EmbryoPhenomics/RoboCam/software/snap_images/snap-17.png

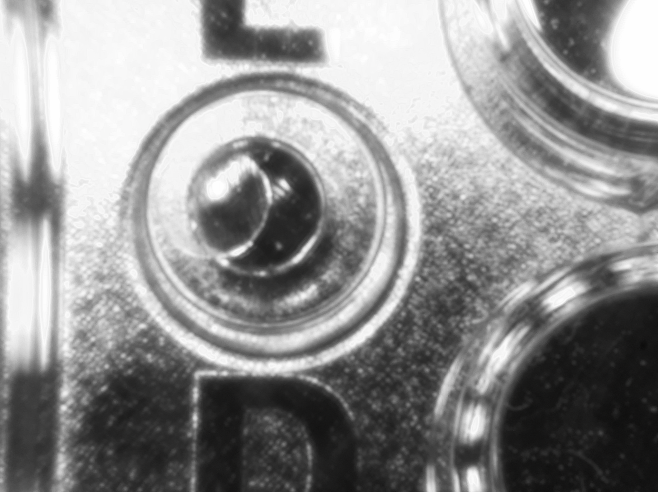
software/snap_images/snap-17.png
