EmbryoPhenomics/RoboCam/software/snap_images/snap-18.png

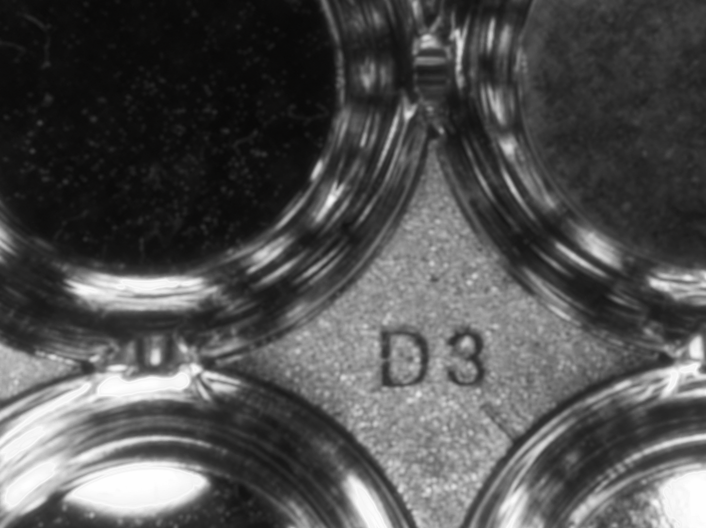
software/snap_images/snap-18.png
