EmbryoPhenomics/RoboCam/software/snap_images/snap-19.png

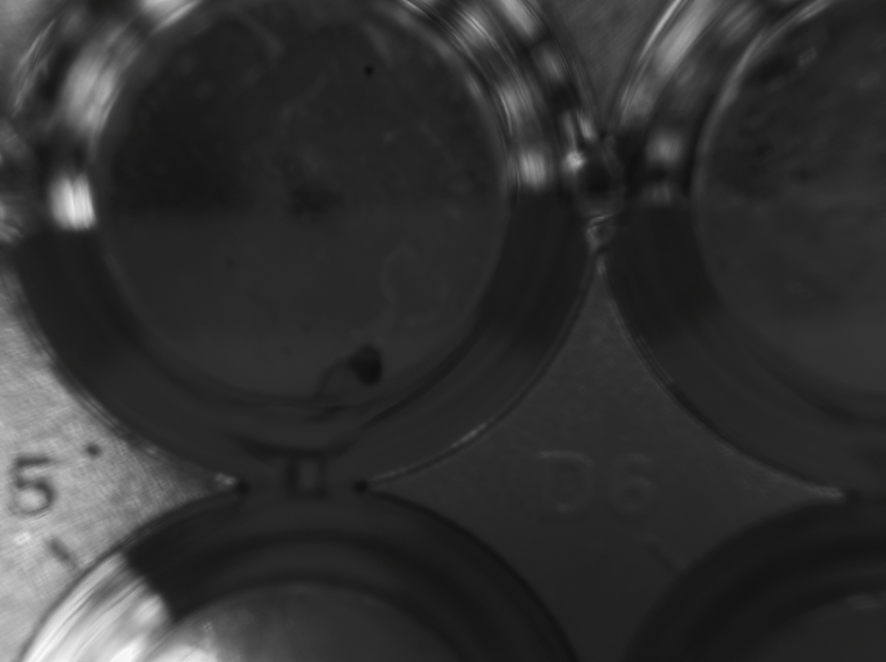
software/snap_images/snap-19.png
