EmbryoPhenomics/RoboCam/software/snap_images/snap-20.png

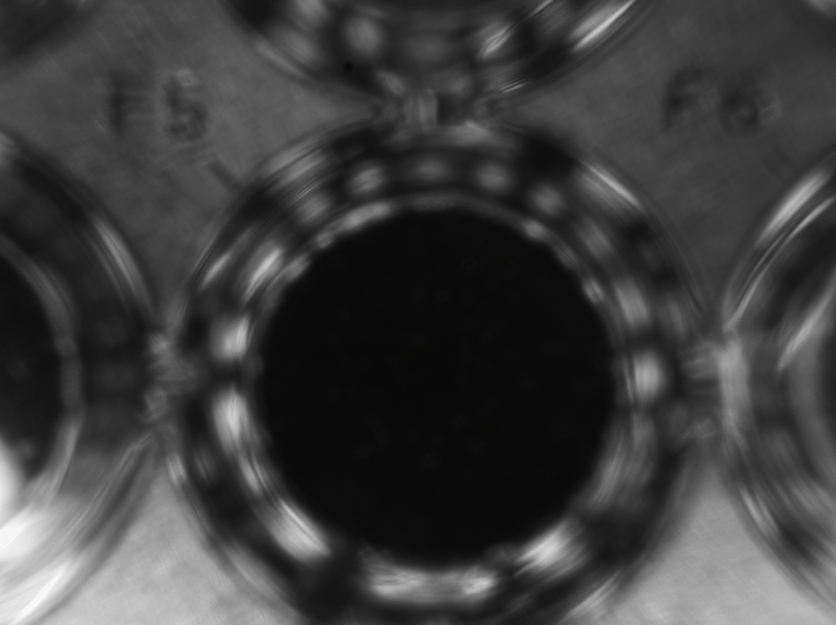
software/snap_images/snap-20.png
