EmbryoPhenomics/RoboCam/software/snap_images/snap-22.png

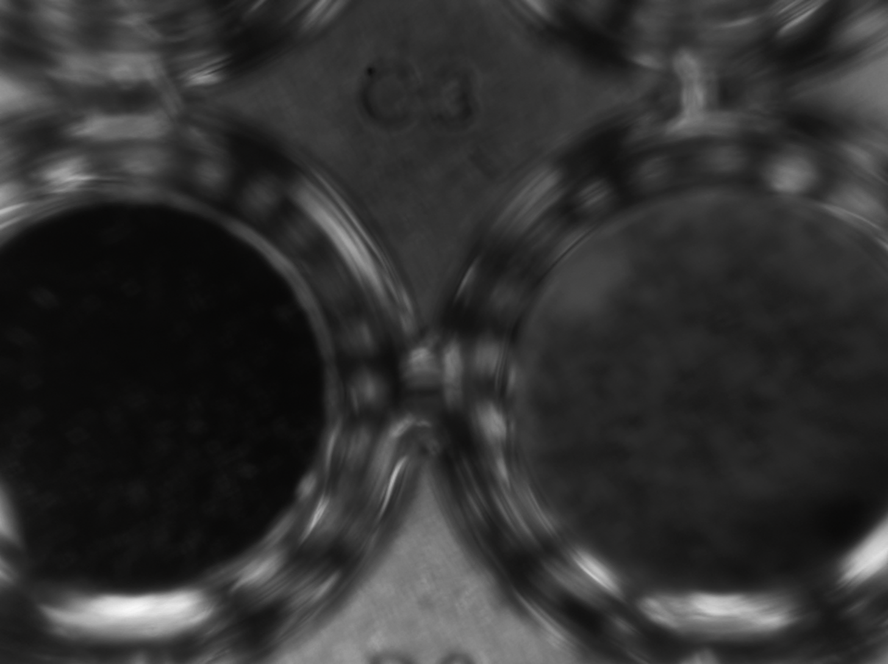
software/snap_images/snap-22.png
