EmbryoPhenomics/RoboCam/software/snap_images/snap-23.png

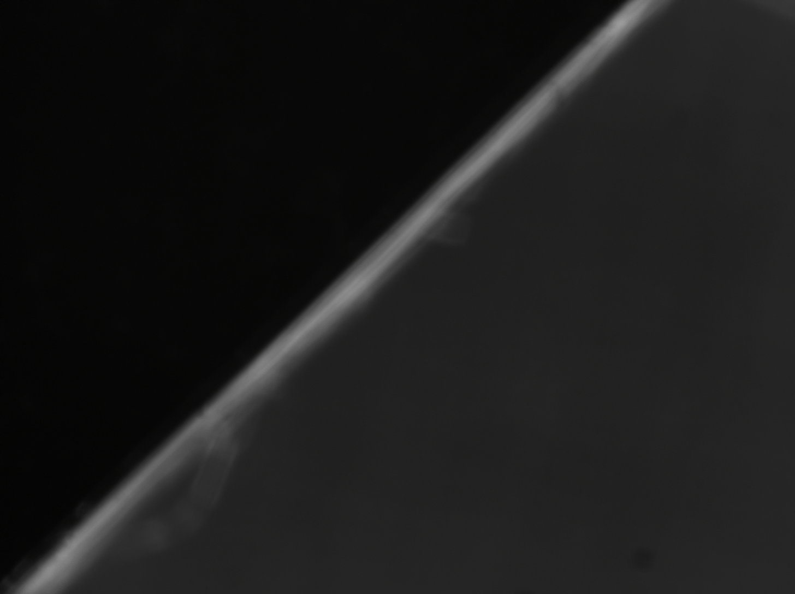
software/snap_images/snap-23.png
