EmbryoPhenomics/RoboCam/software/snap_images/snap-24.png

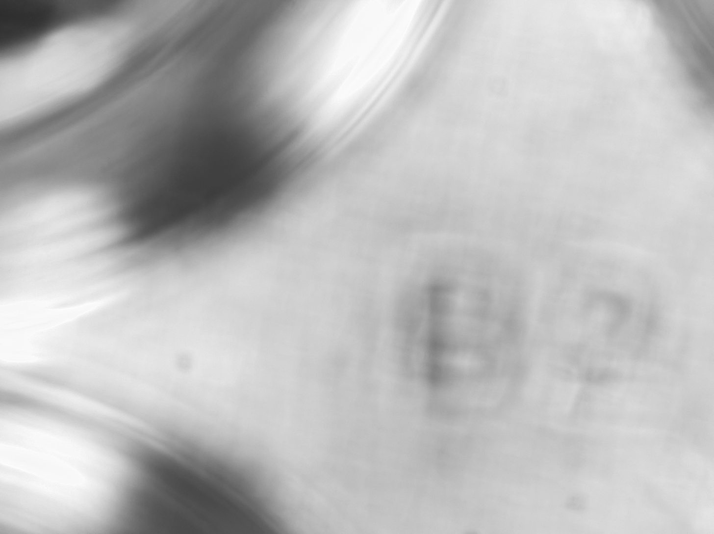
software/snap_images/snap-24.png
