EmbryoPhenomics/RoboCam/software/snap_images/snap-25.png

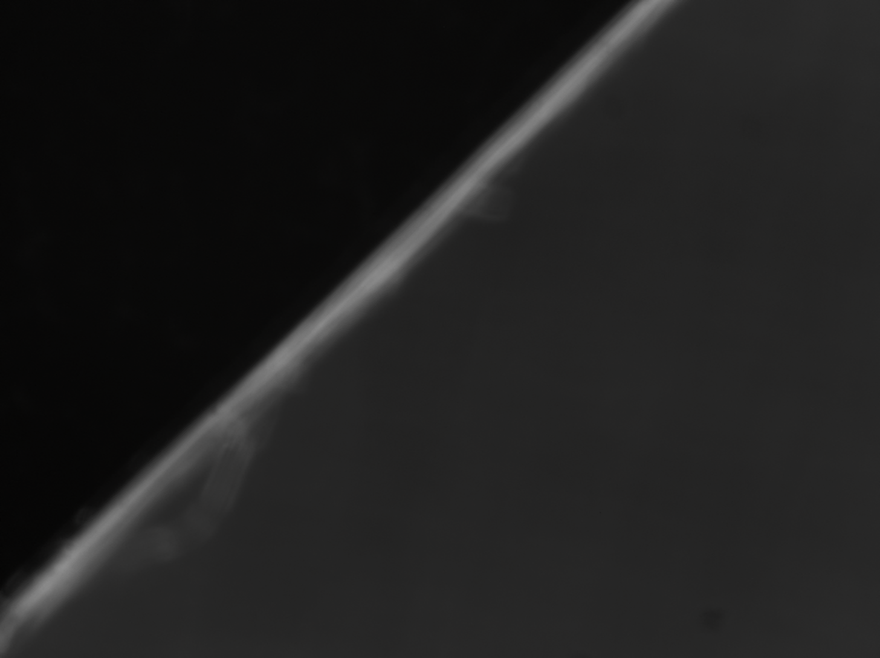
software/snap_images/snap-25.png
