EmbryoPhenomics/RoboCam/electronics/power/manufacturing/LEC_power_v1.2_BOM.csv

Comment | Designator | Footprint | JLCPCB Part #（optional）
10uF | C1,C2 | Capacitor_SMD:C_0805_2012Metric | C440198
0.1uF | C3,C4,C7,C8 | Capacitor_SMD:C_0603_1608Metric | C14663
22uF | C5,C6 | Capacitor_SMD:C_1206_3216Metric | C12891
LED | D1,D2,D3 | LED_SMD:LED_0603_1608Metric | C511604
USB_C_Receptacle_PowerOnly_6P | J6,J7 | Connector_USB:USB_C_Receptacle_GCT_USB4125-xx-x-0190_6P_TopMnt_Horizontal | C456012
3.3uH | L1 | Inductor_SMD:L_Coilcraft_XAL7070-XXX | C3911435
BSS138 | Q1 | Package_TO_SOT_SMD:SOT-23 | C82045
DMP3007SCG-7 | Q2,Q4,Q5 | jlcpcb:V-DFN3333-8_L3.3-W3.3-P0.65-BL | C260899
59kR | R1 | Resistor_SMD:R_0603_1608Metric | C309564
10kR | R2,R3,R5,R10,R11,R12,R13 | Resistor_SMD:R_0603_1608Metric | C98220
20kR | R4 | Resistor_SMD:R_0805_2012Metric | C4328
2.4kR | R6,R8 | Resistor_SMD:R_0603_1608Metric | C22940
100kR | R7 | Resistor_SMD:R_0805_2012Metric | C149504
680R | R9 | Resistor_SMD:R_0603_1608Metric | C23228
1kR | R16,R19 | Resistor_SMD:R_0805_2012Metric | C17513
TPS565201DDCR | U1 | jlcpcb:SOT95P280X110-6N | C327676
TLV9061xDBV | U2,U3 | Package_TO_SOT_SMD:SOT-23-5 | C398358
