EmbryoPhenomics/RoboCam/electronics/ringlight/manufacturing/RL-36W_BOM.csv

Comment | Designator | Footprint | JLCPCB Part # | Notes | Correct?
2.2uF | C1 | Capacitor_SMD:C_1206_3216Metric | C472849
1uF | C2 | Capacitor_SMD:C_1206_3216Metric | C577248
0.1uF | C3,C4 | Capacitor_SMD:C_0402_1005Metric | C307331
10uF | C5,C6 | Capacitor_SMD:C_1206_3216Metric | C5141283
DIODE-SCHOTTKY-MBRA140 | D37 | Diode_SMD:D_SMA | C54798
33uH | L1 | Inductor_SMD:L_Bourns_SRN6045TA | C780211
120R | R1,R2,R3,R4,R5,R6,R7,R8,R9,R10,R11,R12 | attempt_2:R_0402_1005Metric | C911631
0.42R | R13 | Resistor_SMD:R_0603_1608Metric | C705494
3.3kR | R14 | Resistor_SMD:R_0603_1608Metric | C5250825
470R | R15 | Resistor_SMD:R_0402_1005Metric | C2689463
10kR | R16,R17 | Resistor_SMD:R_0603_1608Metric | C99198
AL8860WT | U1 | Package_TO_SOT_SMD:TSOT-23-5 | C125330
DS3502U_ | U2 | attempt_2:SOP50P490X110-10N | C2649363
LM1117MP-3.3 | U3 | Package_TO_SOT_SMD:SOT-223-3_TabPin2 | C9662
