EmbryoPhenomics/RoboCam/electronics/power/Fuse_base_v1.stl

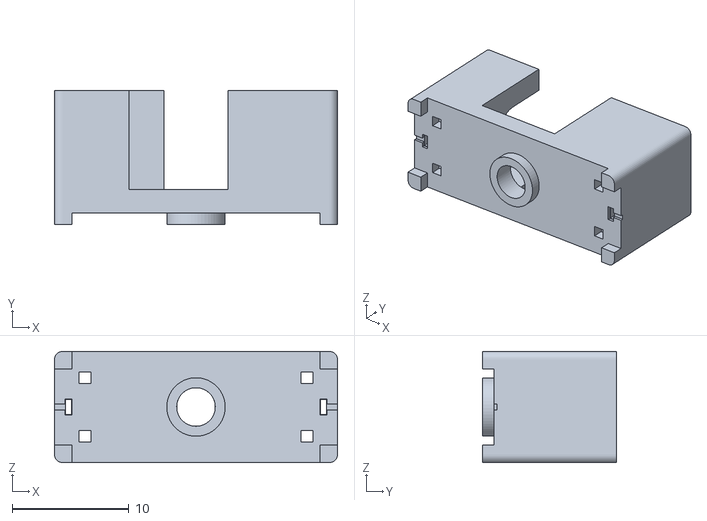
[picture p21: CAD file, 2026-09-18]
electronics/power/Fuse_base_v1.stl
24.2 x 11.5 x 9.50
