EmbryoPhenomics/RoboCam/electronics/power/FUSE_HOLDER/FUSE-HOLDER-20MM-PCB.step

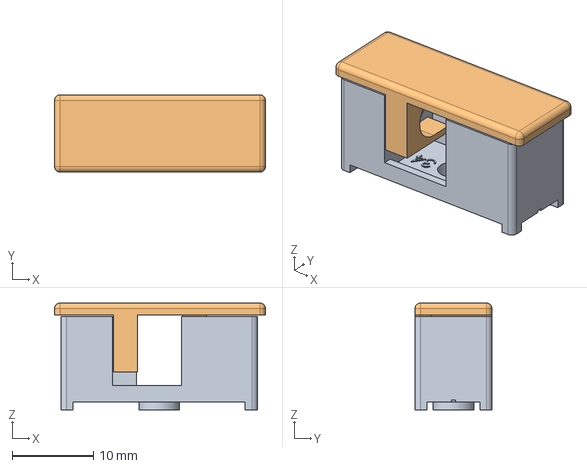
[picture p22: CAD file, 2026-09-18]
electronics/power/FUSE_HOLDER/FUSE-HOLDER-20MM-PCB.step
26.0 x 9.50 x 13.2 mm
Fuse base v1
Fuse cover v1
