EmbryoPhenomics/RoboCam/electronics/ringlight/RL-36W.step

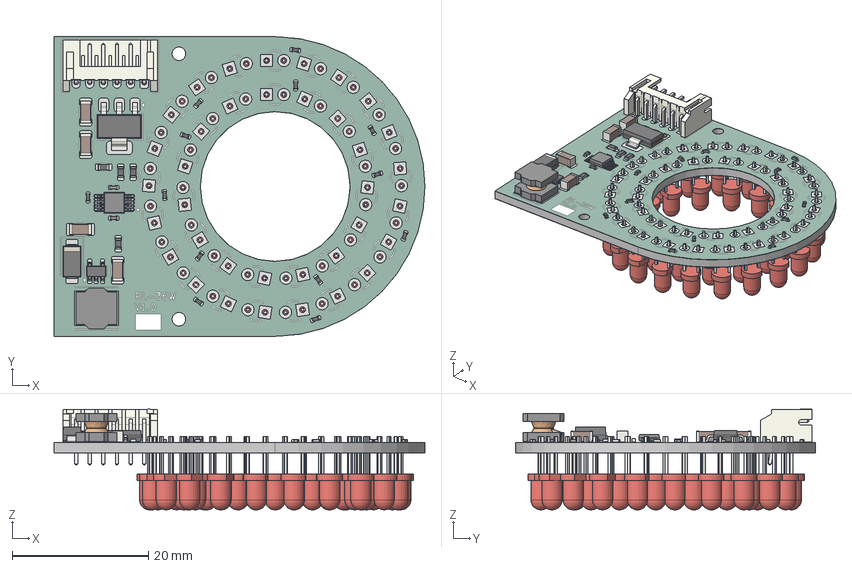
[picture p23: CAD file, 2026-09-18]
electronics/ringlight/RL-36W.step
54.5 x 44.0 x 14.8 mm
R_0402_1005Metric x 13
C_0402_1005Metric x 2
SOT-223
TSOT-23-5
JST_PH_S6B-PH-K_1x06_P2.00mm_Horizontal
R_0603_1608Metric x 4
C_1206_3216Metric x 4
L_Bourns_SRN6045TA
DS3502U_
D_SMA
LED_D3.0mm x 36
RL-36W_copper
RL-36W_pad
RL-36W_via
RL-36W_silkscreen
RL-36W_soldermask x 2
RL-36W_PCB
