EmbryoPhenomics/RoboCam/electronics/power/Fuse_cover_v1.stl

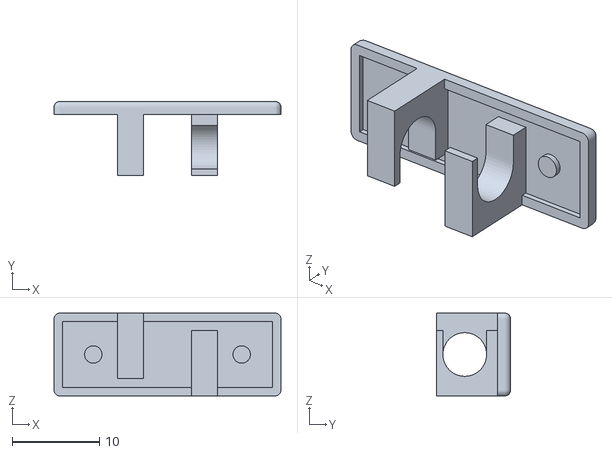
[picture p24: CAD file, 2026-09-18]
electronics/power/Fuse_cover_v1.stl
26.0 x 8.50 x 9.50
