EmbryoPhenomics/RoboCam/electronics/power/LEC_power_v1.2.step

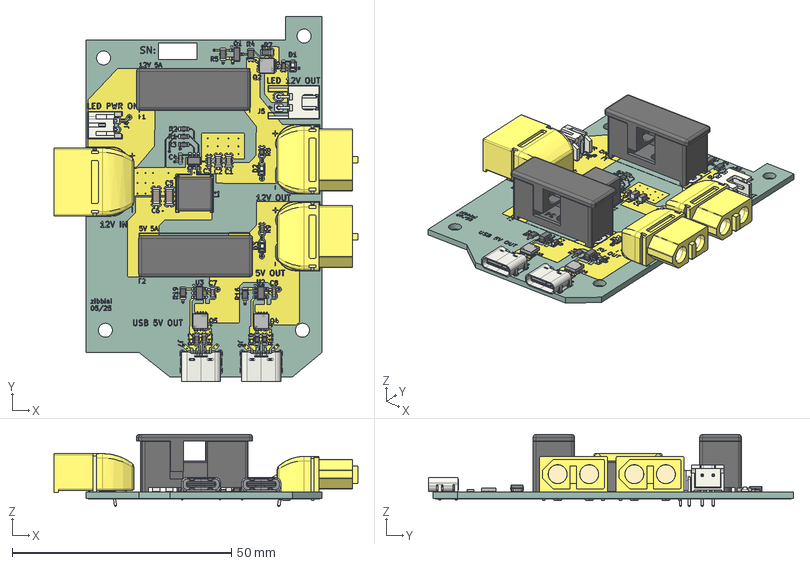
[picture p25: CAD file, 2026-09-18]
electronics/power/LEC_power_v1.2.step
69.3 x 83.4 x 16.5 mm
C_1206_3216Metric x 2
R_0805_2012Metric x 5
R_0603_1608Metric x 10
C_0603_1608Metric x 4
LED_0603_1608Metric x 3
SOT-23-5 x 2
JST_PH_S2B-PH-K_1x02_P2.00mm_Horizontal
XT60PW FEMALE x 2
V-DFN3333-8_L3.3-W3.3-H0.8-P0.65-BL x 3
C_0805_2012Metric x 2
USB_C_Receptacle_GCT_USB4125-xx-x-0190_6P_TopMnt_Horizontal x 2
SOT-23
Fuse base v1 x 2
Fuse cover v1 x 2
JST_XH_S2B-XH-A_1x02_P2.50mm_Horizontal
L_Coilcraft_XAL7070-XXX
TPS565201DDCR
XT60PW MALE
LEC_power_v1.2_copper
LEC_power_v1.2_pad
LEC_power_v1.2_via
LEC_power_v1.2_silkscreen
LEC_power_v1.2_PCB
