EmbryoPhenomics/RoboCam/electronics/power/TPS565201DDCR/TPS565201DDCR.step

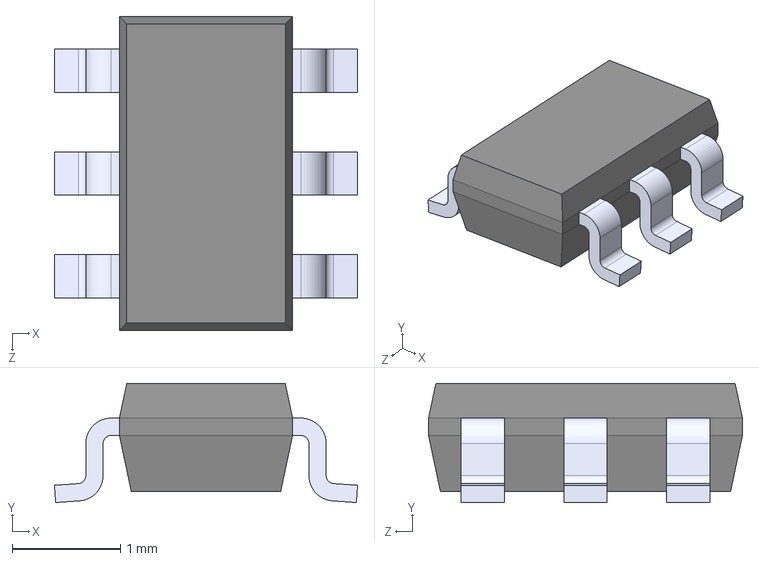
[picture p26: CAD file, 2026-09-18]
electronics/power/TPS565201DDCR/TPS565201DDCR.step
2.80 x 1.10 x 2.90 mm
