EmbryoPhenomics/RoboCam/electronics/power/LEC_power_v1.2_schematic.pdf

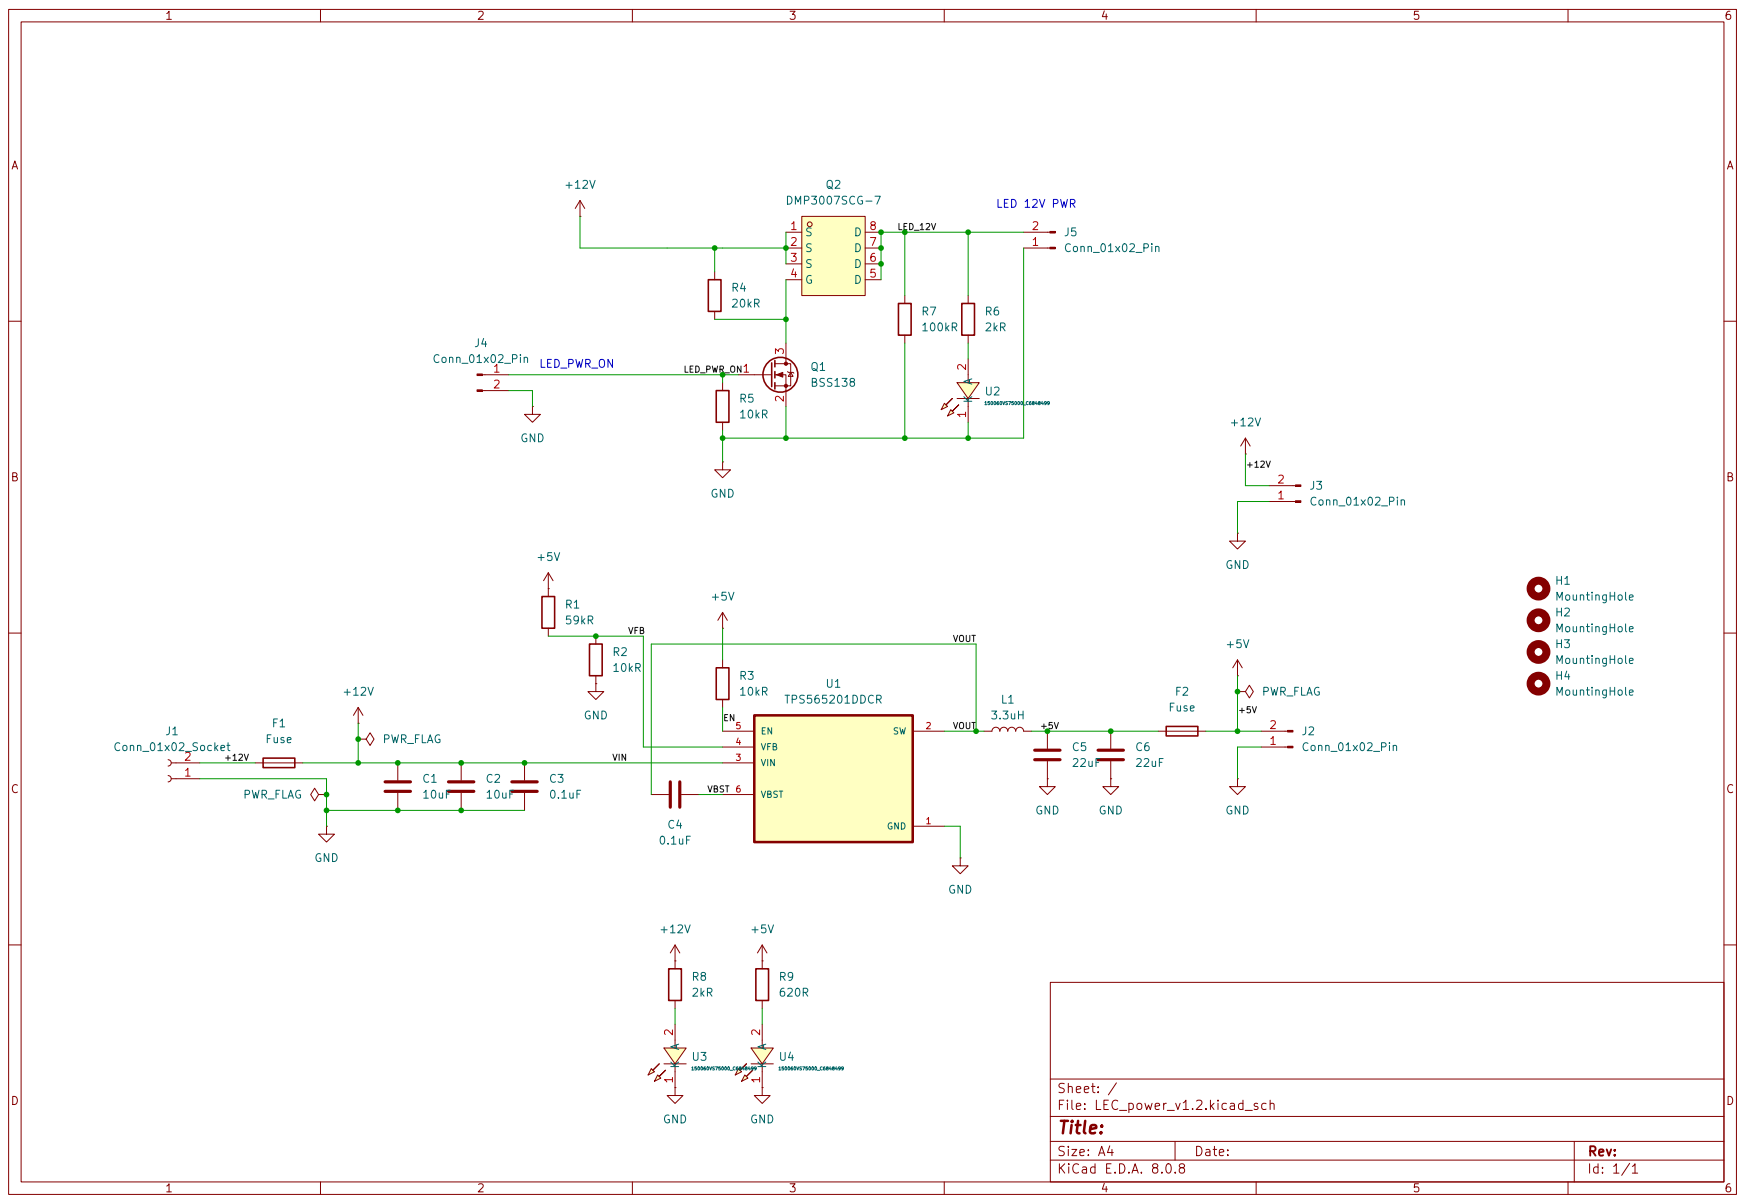
[picture p27: page 1]
