EmbryoPhenomics/RoboCam/electronics/ringlight/RL-36W.kicad_pcb

## KiCad design electronics/ringlight/RL-36W.kicad_pcb (2026-09-18)

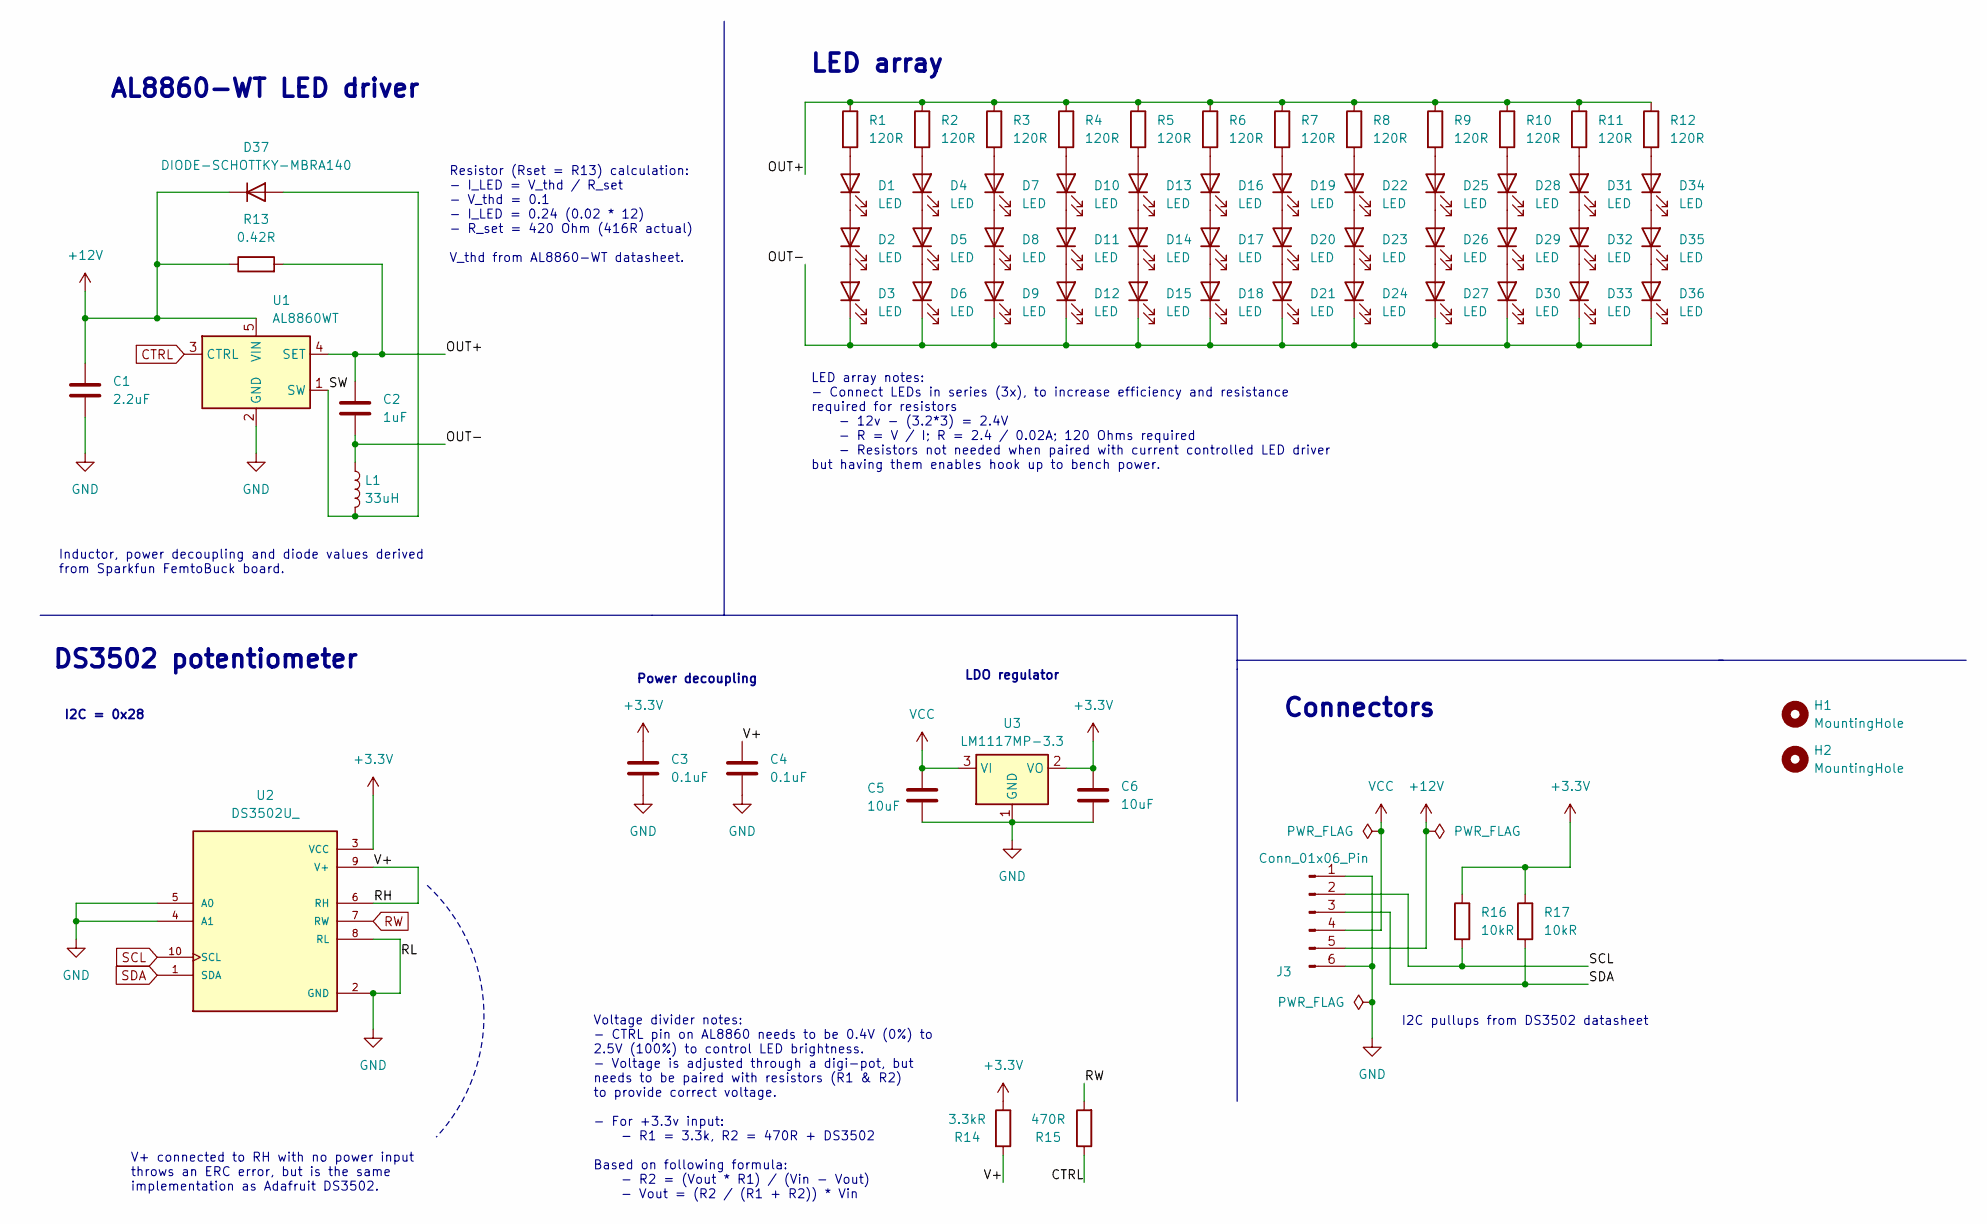
[picture p28: schematic RL-36W.kicad_sch]

Parts:
C1: 2.2uF; C_1206_3216Metric
C2: 1uF; C_1206_3216Metric
C3, C4: 0.1uF; C_0402_1005Metric
C5, C6: 10uF; C_1206_3216Metric
D1, D2, D3, D4, D5, D6, D7, D8, D9, D10, D11, D12, D13, D14, D15, D16, D17, D18, D19, D20, D21, D22, D23, D24, D25, D26, D27, D28, D29, D30, D31, D32, D33, D34, D35, D36: LED; LED_D3.0mm_2
D37: DIODE-SCHOTTKY-MBRA140; D_SMA
H1, H2: MountingHole; MountingHole_2mm
J3: Conn_01x06_Pin; JST_PH_S6B-PH-K_1x06_P2.00mm_Horizontal
L1: 33uH; L_Bourns_SRN6045TA
R1, R2, R3, R4, R5, R6, R7, R8, R9, R10, R11, R12: 120R; R_0402_1005Metric
R13: 0.42R; R_0603_1608Metric
R14: 3.3kR; R_0603_1608Metric
R15: 470R; R_0402_1005Metric
R16, R17: 10kR; R_0603_1608Metric
U1: AL8860WT; TSOT-23-5
U2: DS3502U_; SOP50P490X110-10N; PARTREV 1
U3: LM1117MP-3.3; SOT-223-3_TabPin2

Connections:
+3.3V: C3.1, C6.1, R14.1, R16.1, R17.1, U2.3 (VCC), U3.2 (VO)
+12V: C1.1, D37.1 (K), J3.5, R13.1, U1.5 (VIN)
/OUT+: C2.1, R1.1, R2.1, R3.1, R4.1, R5.1, R6.1, R7.1, R8.1, R9.1, R10.1, R11.1, R12.1, R13.2, U1.4 (SET)
/OUT-: C2.2, D3.1 (K), D6.1 (K), D9.1 (K), D12.1 (K), D15.1 (K), D18.1 (K), D21.1 (K), D24.1 (K), D27.1 (K), D30.1 (K), D33.1 (K), D36.1 (K), L1.1
/RH: C4.1, R14.2, U2.6 (RH), U2.9 (V+)
/SW: D37.2 (A), L1.2, U1.1 (SW)
CTRL: R15.1, U1.3 (CTRL)
GND: C1.2, C3.2, C4.2, C5.2, C6.2, J3.1, J3.6, U1.2 (GND), U2.2 (GND), U2.4 (A1), U2.5 (A0), U2.8 (RL), U3.1 (GND)
unnamed: D1.2 (A), R1.2
unnamed: D1.1 (K), D2.2 (A)
unnamed: D2.1 (K), D3.2 (A)
unnamed: D4.2 (A), R2.2
unnamed: D4.1 (K), D5.2 (A)
unnamed: D5.1 (K), D6.2 (A)
unnamed: D7.2 (A), R3.2
unnamed: D7.1 (K), D8.2 (A)
unnamed: D8.1 (K), D9.2 (A)
unnamed: D10.2 (A), R4.2
unnamed: D10.1 (K), D11.2 (A)
unnamed: D11.1 (K), D12.2 (A)
unnamed: D13.2 (A), R5.2
unnamed: D13.1 (K), D14.2 (A)
unnamed: D14.1 (K), D15.2 (A)
unnamed: D16.2 (A), R6.2
unnamed: D16.1 (K), D17.2 (A)
unnamed: D17.1 (K), D18.2 (A)
unnamed: D19.2 (A), R7.2
unnamed: D19.1 (K), D20.2 (A)
unnamed: D20.1 (K), D21.2 (A)
unnamed: D22.2 (A), R8.2
unnamed: D22.1 (K), D23.2 (A)
unnamed: D23.1 (K), D24.2 (A)
unnamed: D25.2 (A), R9.2
unnamed: D25.1 (K), D26.2 (A)
unnamed: D26.1 (K), D27.2 (A)
unnamed: D28.2 (A), R10.2
unnamed: D28.1 (K), D29.2 (A)
unnamed: D29.1 (K), D30.2 (A)
unnamed: D31.2 (A), R11.2
unnamed: D31.1 (K), D32.2 (A)
unnamed: D32.1 (K), D33.2 (A)
unnamed: D34.2 (A), R12.2
unnamed: D34.1 (K), D35.2 (A)
unnamed: D35.1 (K), D36.2 (A)
RW: R15.2, U2.7 (RW)
SCL: J3.2, R16.2, U2.10 (SCL)
SDA: J3.3, R17.2, U2.1 (SDA)
VCC: C5.1, J3.4, U3.3 (VI)

Notes on the sheet:
V+ connected to RH with no power input throws an ERC error, but is the same implementation as Adafruit DS3502.
I2C = 0x28
LED array notes: - Connect LEDs in series (3x), to increase efficiency and resistance required for resistors - 12v - (3.2*3) = 2.4V - R = V / I; R = 2.4 / 0.02A; 120 Ohms required - Resistors not needed when paired with current controlled LED driver but having them enables hook up to bench power.
Connectors
LED array
Resistor (Rset = R13) calculation: - I_LED = V_thd / R_set - V_thd = 0.1 - I_LED = 0.24 (0.02 * 12) - R_set = 420 Ohm (416R actual) V_thd from AL8860-WT datasheet.
Power decoupling
Inductor, power decoupling and diode values derived from Sparkfun FemtoBuck board.
DS3502 potentiometer
Voltage divider notes: - CTRL pin on AL8860 needs to be 0.4V (0%) to 2.5V (100%) to control LED brightness. - Voltage is adjusted through a digi-pot, but needs to be paired with resistors (R1 & R2) to provide correct voltage. - For +3.3v input: - R1 = 3.3k, R2 = 470R + DS3502 Based on following for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
LDO regulator
AL8860-WT LED driver
I2C pullups from DS3502 datasheet

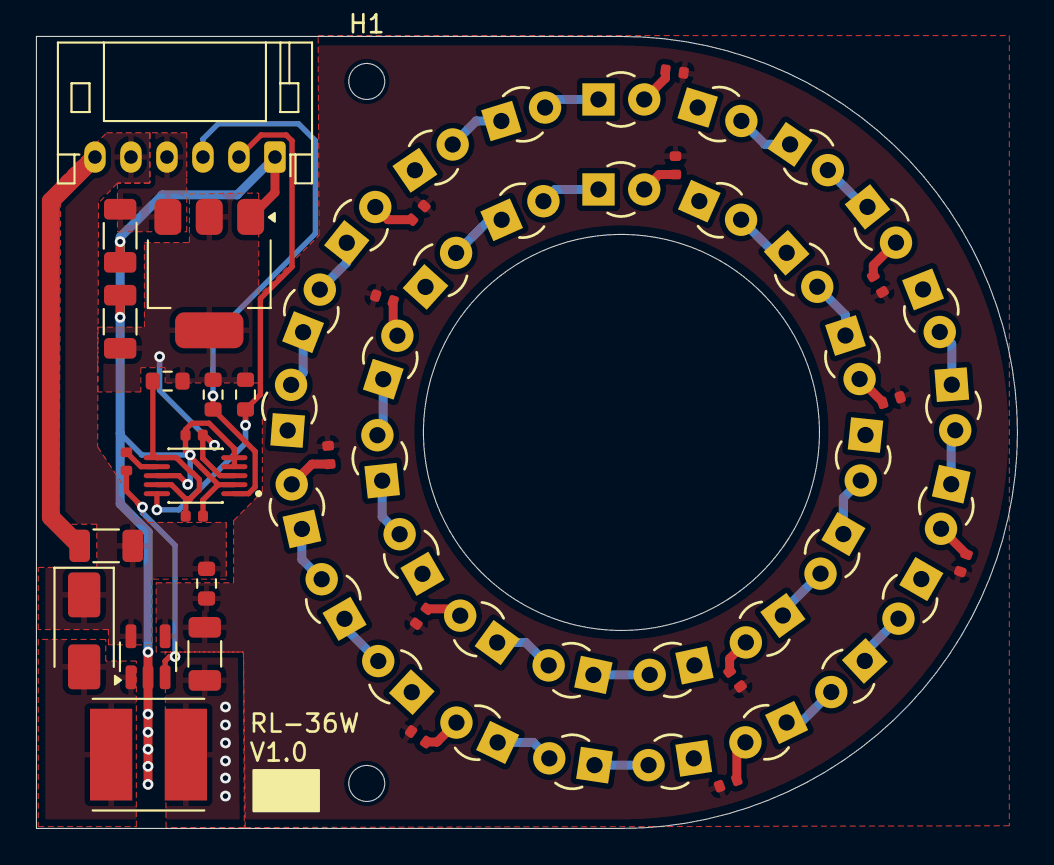
[picture p29: board RL-36W.kicad_pcb from above]

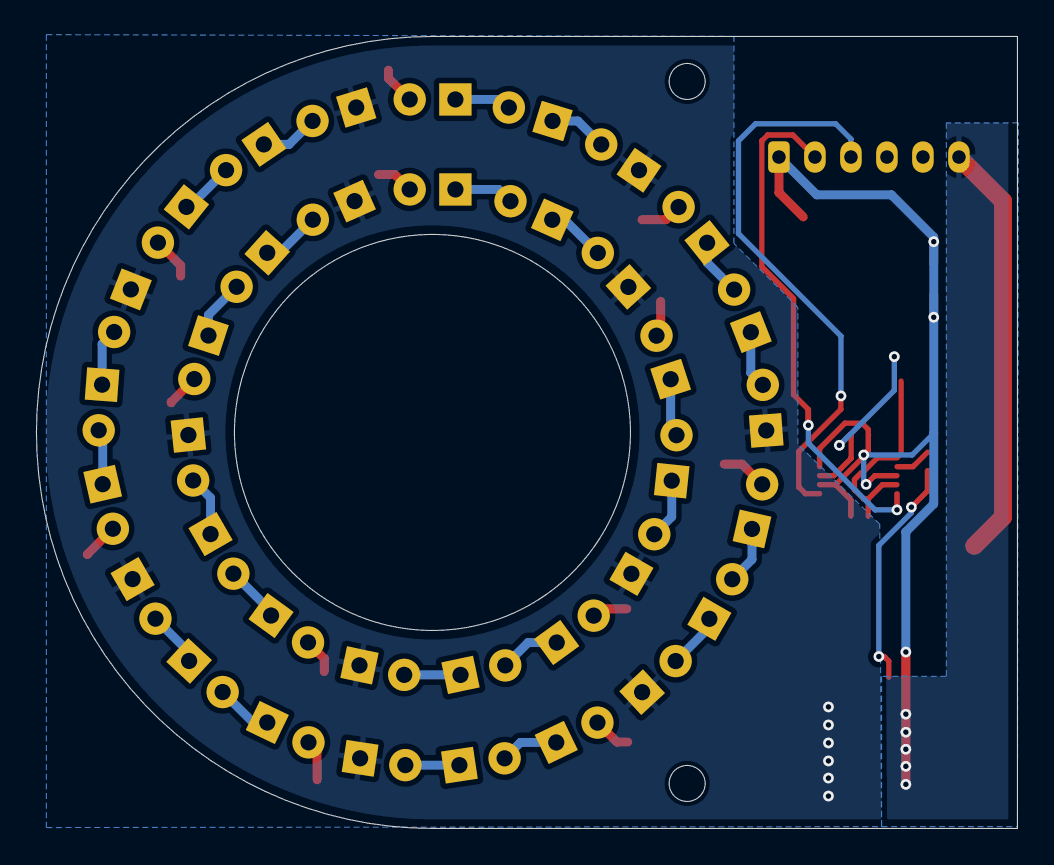
[picture p30: board RL-36W.kicad_pcb from below]

Board: 2 copper layers, 54.5 x 44.0 mm, 67 parts (36 on the bottom side), 48 nets.
