EmbryoPhenomics/RoboCam/electronics/power/LEC_power_v1.2.kicad_pcb

## KiCad design electronics/power/LEC_power_v1.2.kicad_pcb (2026-09-18)

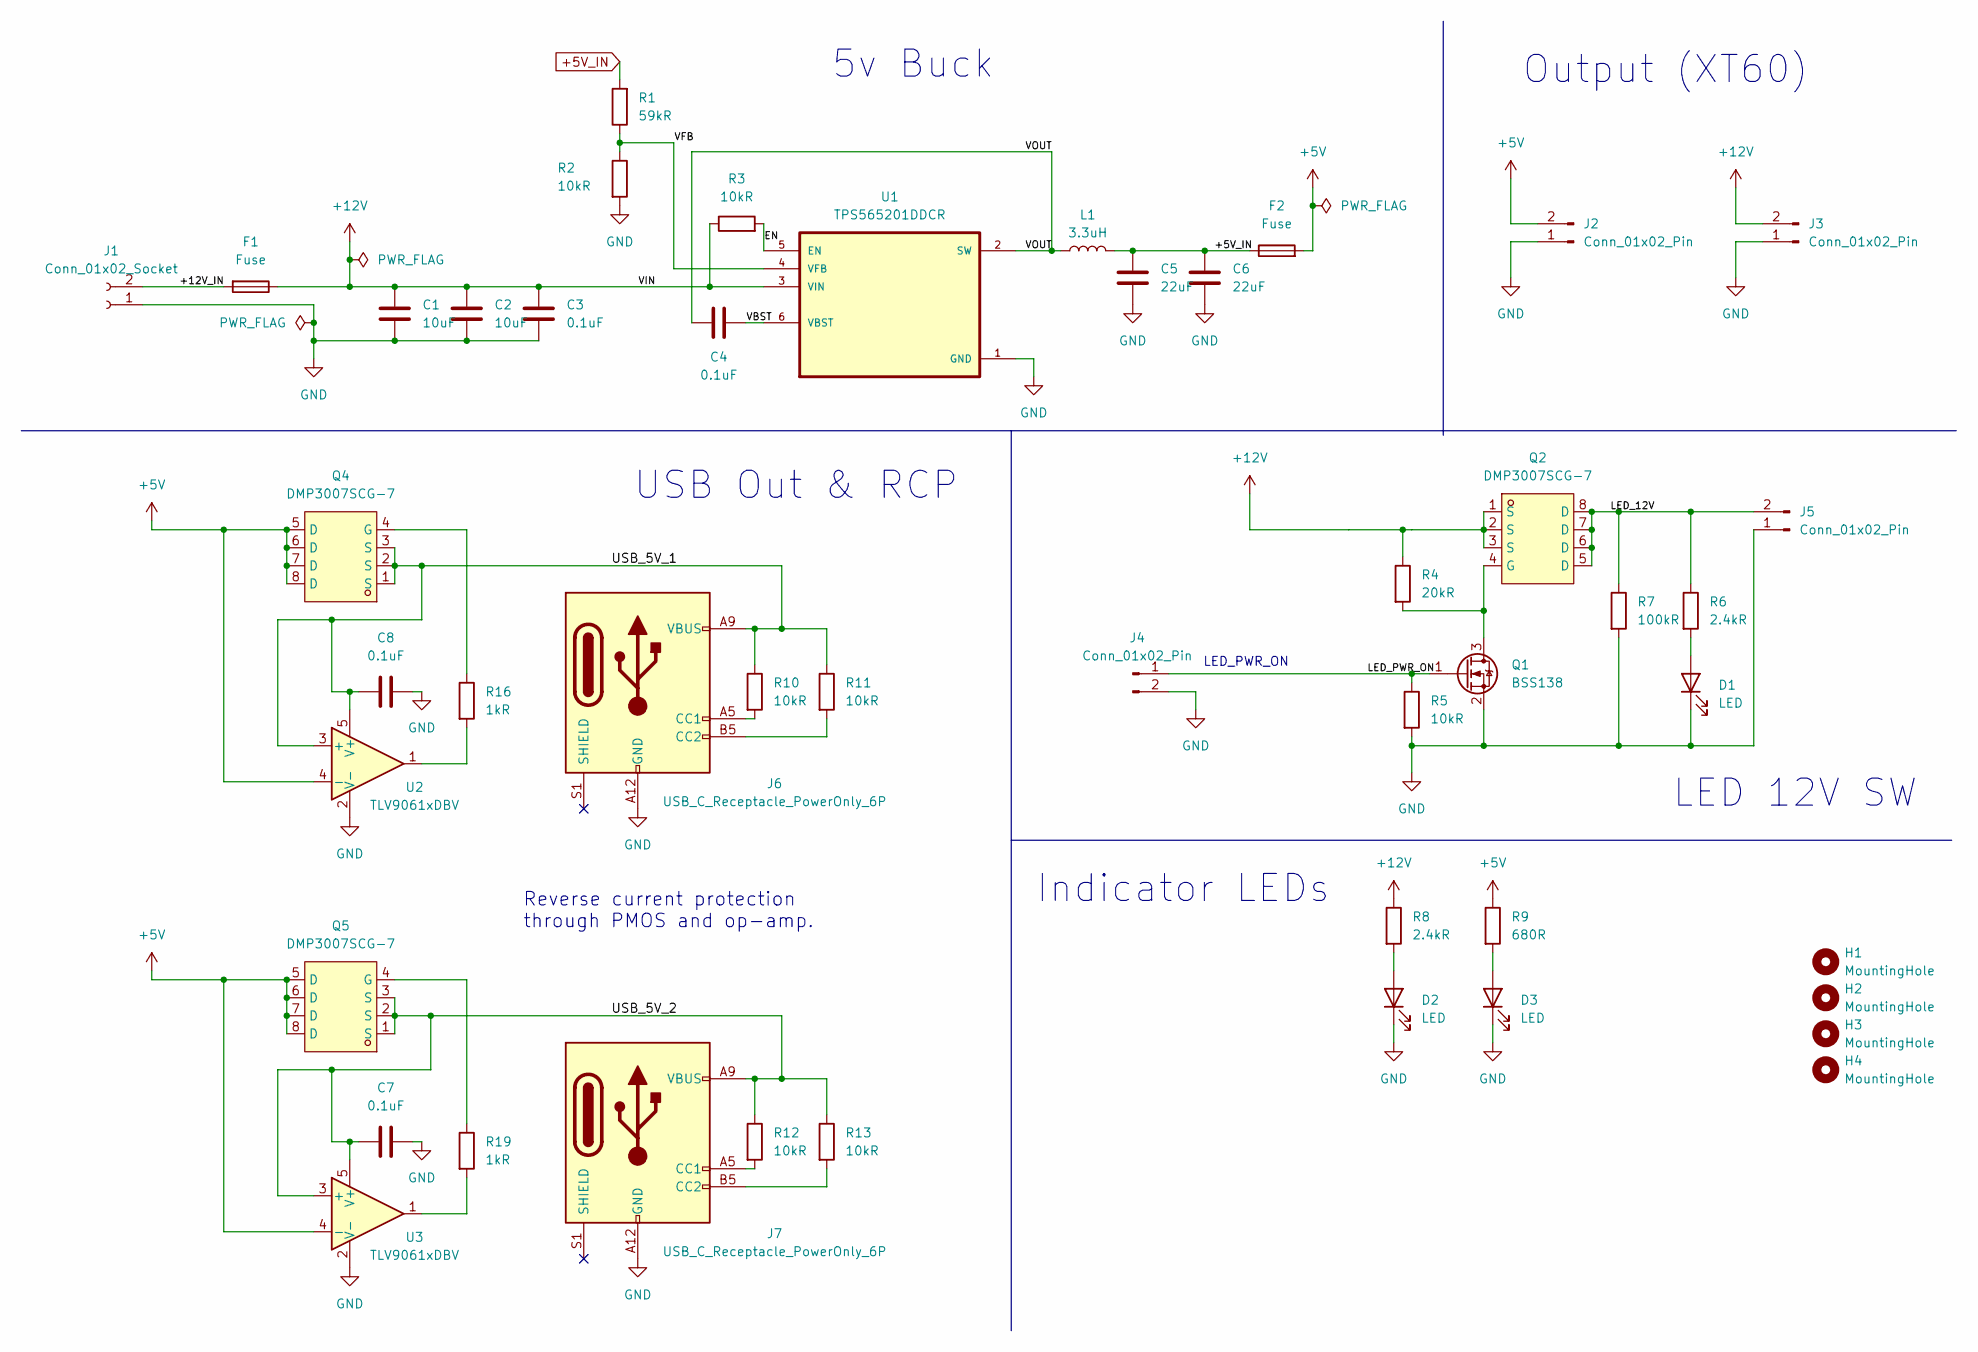
[picture p31: schematic LEC_power_v1.2.kicad_sch]

Parts:
C1, C2: 10uF; C_0805_2012Metric
C3, C4, C7, C8: 0.1uF; C_0603_1608Metric
C5, C6: 22uF; C_1206_3216Metric
D1, D2, D3: LED; LED_0603_1608Metric
F1, F2: Fuse; CamdenBoss_FuseHolder_5x20mm
H1, H2, H3, H4: MountingHole; MountingHole_3.2mm_M3
J1: Conn_01x02_Socket; AMASS_XT60PW-M_1x02_P7.20mm_Horizontal
J2, J3: Conn_01x02_Pin; AMASS_XT60PW-F_1x02_P7.20mm_Horizontal
J4: Conn_01x02_Pin; JST_PH_S2B-PH-K_1x02_P2.00mm_Horizontal
J5: Conn_01x02_Pin; JST_XH_S2B-XH-A_1x02_P2.50mm_Horizontal
J6, J7: USB_C_Receptacle_PowerOnly_6P; USB_C_Receptacle_GCT_USB4125-xx-x-0190_6P_TopMnt_Horizontal
L1: 3.3uH; L_Coilcraft_XAL7070-XXX
Q1: BSS138; SOT-23
Q2, Q4, Q5: DMP3007SCG-7; V-DFN3333-8_L3.3-W3.3-P0.65-BL; LCSC Part C260899
R1: 59kR; R_0603_1608Metric
R2, R3, R5, R10, R11, R12, R13: 10kR; R_0603_1608Metric
R4: 20kR; R_0603_1608Metric
R6, R8: 2.4kR; R_0603_1608Metric
R7: 100kR; R_0603_1608Metric
R9: 680R; R_0603_1608Metric
R16, R19: 1kR; R_0603_1608Metric
U1: TPS565201DDCR; SOT95P280X110-6N
U2, U3: TLV9061xDBV; SOT-23-5

Connections:
+5V: F2.2, J2.2, Q4.5 (D), Q4.6 (D), Q4.7 (D), Q4.8 (D), Q5.5 (D), Q5.6 (D), Q5.7 (D), Q5.8 (D), R9.1, U2.4 (-), U3.4 (-)
+5V_IN: C5.1, C6.1, F2.1, L1.2, R1.2
+12V: C1.1, C2.1, C3.1, F1.1, J3.2, Q2.1 (S), Q2.2 (S), Q2.3 (S), R3.1, R4.1, R8.1, U1.3 (VIN)
/+12V_IN: F1.2, J1.2
/EN: R3.2, U1.5 (EN)
/LED_12V: J5.2, Q2.5 (D), Q2.6 (D), Q2.7 (D), Q2.8 (D), R6.1, R7.1
/LED_PWR_ON: J4.1, Q1.1 (G), R5.1
/USB_5V_1: C8.1, J6.A9 (VBUS), J6.B9 (VBUS), Q4.1 (S), Q4.2 (S), Q4.3 (S), R10.1, R11.1, U2.3 (+), U2.5 (V+)
/USB_5V_2: C7.1, J7.A9 (VBUS), J7.B9 (VBUS), Q5.1 (S), Q5.2 (S), Q5.3 (S), R12.1, R13.1, U3.3 (+), U3.5 (V+)
/VBST: C4.1, U1.6 (VBST)
/VFB: R1.1, R2.1, U1.4 (VFB)
/VOUT: C4.2, L1.1, U1.2 (SW)
GND: C1.2, C2.2, C3.2, C5.2, C6.2, C7.2, C8.2, D1.1 (K), D2.1 (K), D3.1 (K), J1.1, J2.1, J3.1, J4.2, J5.1, J6.A12 (GND), J6.B12 (GND), J7.A12 (GND), J7.B12 (GND), Q1.2 (S), R2.2, R5.2, R7.2, U1.1 (GND), U2.2 (V-), U3.2 (V-)
unnamed: D1.2 (A), R6.2
unnamed: D2.2 (A), R8.2
unnamed: D3.2 (A), R9.2
unnamed: J6.A5 (CC1), R10.2
unnamed: J6.B5 (CC2), R11.2
unnamed: J7.A5 (CC1), R12.2
unnamed: J7.B5 (CC2), R13.2
unnamed: Q1.3 (D), Q2.4 (G), R4.2
unnamed: Q4.4 (G), R16.1
unnamed: Q5.4 (G), R19.1
unnamed: R16.2, U2.1
unnamed: R19.2, U3.1

Notes on the sheet:
5v Buck
USB Out & RCP
Reverse current protection through PMOS and op-amp.
LED_PWR_ON
LED 12V SW
Output (XT60)
Indicator LEDs

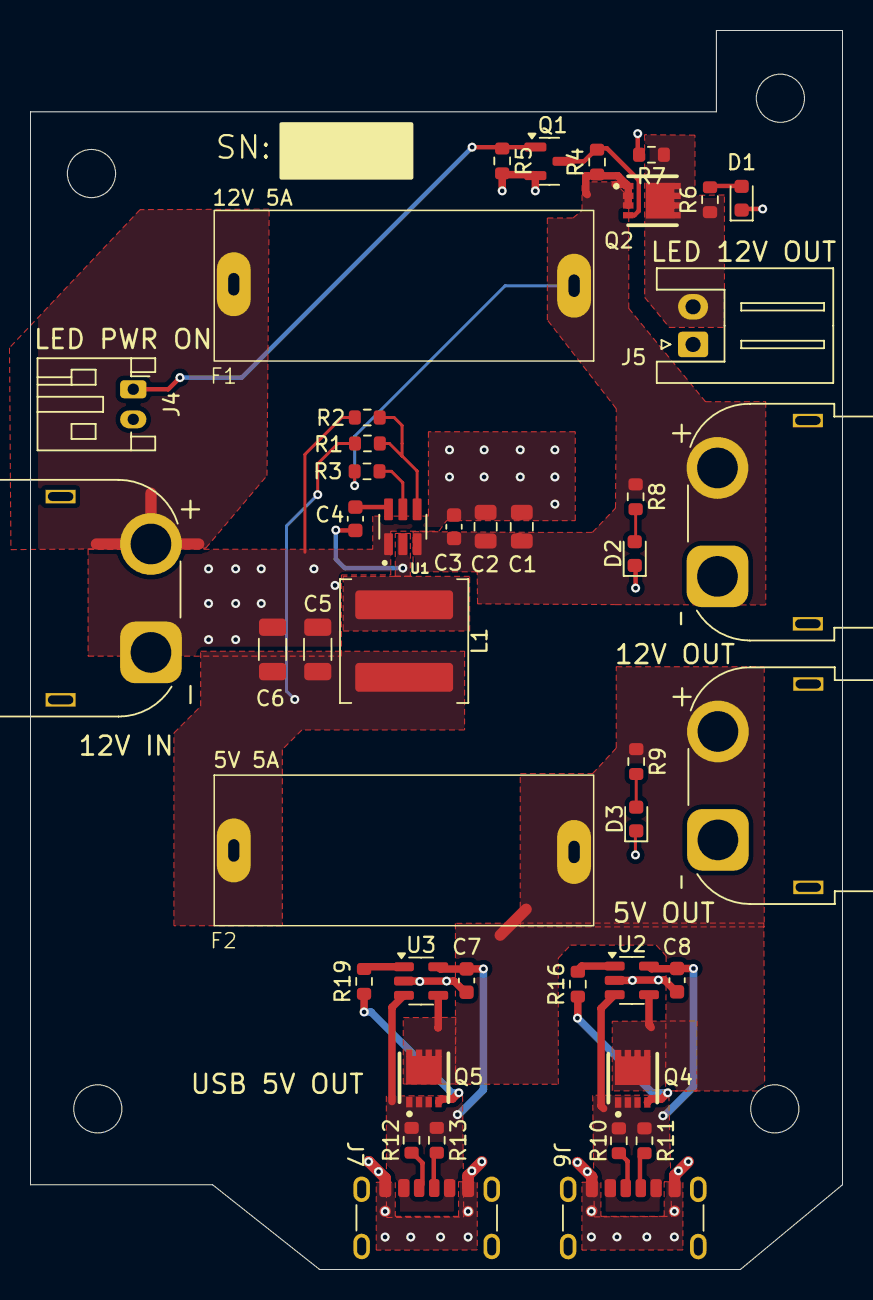
[picture p32: board LEC_power_v1.2.kicad_pcb from above]

Board: 2 copper layers, 53.9 x 82.3 mm, 47 parts (0 on the bottom side), 25 nets.
