EmbryoPhenomics/RoboCam/software/camera_backend_picamera2.py

import cv2
import picamera2
from tqdm import tqdm
import time

import cv2 
import time as timelib
from tqdm import tqdm
from collections import deque
import numpy as np
import threading
import re
import pandas as pd
import subprocess as sp
import atexit
import gc
import re
import math
import vuba
from tkinter import *
from PIL import ImageTk, Image
import subprocess
import signal
import prctl
import json

from picamera2.encoders import JpegEncoder
from ffmpegoutput import FfmpegOutput
import simplejpeg

from camera_benchmark import CaptureBenchmark

font = cv2.FONT_HERSHEY_SIMPLEX
fontScale = 0.5
fontColor = (255,255,255)
lineType = 1

with open('./app_config.json', 'r') as conf:
    app_conf = json.load(conf)
    lec_version = app_conf['LEC_version']

class LiveOptFlow:
    def __init__(self):
        self.feature_params = dict(
            maxCorners=500,
            qualityLevel=0.001,
            minDistance=0,
            blockSize=7,
            useHarrisDetector=0,
            k=0.4,
        )

        # Parameters for lucas kanade optical flow
        self.lk_params = dict(
            winSize=(15, 15),
            maxLevel=2,
            criteria=(cv2.TERM_CRITERIA_EPS | cv2.TERM_CRITERIA_COUNT, 10, 0.03),
        )

    def register_first(self, frame):
        self.first = frame
        self.p0 = cv2.goodFeaturesToTrack(frame, mask=None, **self.feature_params)
        self.rot_mask = cv2.cvtColor(np.zeros_like(frame), cv2.COLOR_GRAY2BGR)
        self.point_log = deque(maxlen=5) # Max point memory of 5

    def render(self, frame):
        p1, st, err = cv2.calcOpticalFlowPyrLK(self.first, frame, self.p0, None, **self.lk_params)
    
        frame_view = vuba.bgr(frame)
        if p1 is None:
            good_new = None
            good_old = None
        else:    
            good_new = p1[st == 1]
            good_old = self.p0[st == 1]

        if good_new is not None and good_old is not None:
            ind_diff = good_new - good_old
            rot = np.asarray(
                list(map(lambda vals: math.atan2(*np.flip(vals)), ind_diff))
            ) # compute angles of rotation                

            self.point_log.append((good_old, good_new, rot, ind_diff))
            
            for (good_old, good_new, rot, diff) in self.point_log:
                for old, new, r, d in zip(good_old, good_new, rot, diff):
                    if math.sqrt(d[0]**2 + d[1]**2) < 0.5:
                        continue
                    
                    old, new = map(tuple, (old, new))

                    rot_line_color = (0, 0, 255)
                    if r > 0:
                        rot_line_color = (0, 255, 255)

                    new = tuple(map(int, new))
                    old = tuple(map(int, old))
                    cv2.line(frame_view, new, old, rot_line_color, 1)

                if len(good_old) and len(good_new):
                    com_old = good_old.mean(axis=(0,))
                    com_new = good_new.mean(axis=(0,))
                    com_old, com_new = map(tuple, (com_old, com_new))  # for live view

                    com_new = tuple(map(int, com_new))
                    com_old = tuple(map(int, com_old))
                    cv2.line(frame_view, com_new, com_old, (255, 0, 0), 2)

        self.first = frame.copy()

        if p1 is None:
            self.p0 = self.p0.reshape(-1, 1, 2)
        else:
            self.p0 = good_new.reshape(-1, 1, 2)

        #return np.vstack((frame_view, self.rot_mask))
        #resized_mask = cv2.resize(self.rot_mask, (round(self.rot_mask.shape[1]/3), round(self.rot_mask.shape[0]/3)))
        #white_border = np.full((resized_mask.shape[0]+2, resized_mask.shape[1]+2, 3), 255).astype(np.uint8)
        
        #frame_view[:white_border.shape[0], :white_border.shape[1]] = white_border[:]
        #frame_view[:resized_mask.shape[0], :resized_mask.shape[1]] = resized_mask[:]
        #cv2.putText(frame_view, 'Optical Flow Live Stream',
        #            tuple(map(int, (0.01*frame_view.shape[1], 0.02*frame_view.shape[0]))),
        #            font, fontScale, fontColor, lineType)
        return frame_view


# Updated API for Picamera2 ------------------------------------------------------------ #
def disable_event():
    pass
    
class TkImageViewer:
    def __init__(self):
        self.root = Tk()
        self.root.title('Video Playback')
        self.lmain = Label(self.root)
        self.lmain.pack()
        self.root.protocol("WM_DELETE_WINDOW", disable_event)

    def show_frame(self, img):
        imgtk = ImageTk.PhotoImage(image=img)
        self.lmain.imgtk = imgtk
        self.lmain.configure(image=imgtk)
        self.root.update()

    def close(self):
        self.root.destroy()

# Custom Encoder functions for picamera2 -------------------------------
# Performs array flipping to match live view of camera
def encode_func(self, request, name):
    """Performs encoding

    :param request: Request
    :type request: request
    :param name: Name
    :type name: str
    :return: Jpeg image
    :rtype: bytes
    """
    if self.colour_space is None:
        self.colour_space = self.FORMAT_TABLE[request.config[name]["format"]]
    array = request.make_array(name)

    if lec_version == 'V2':
        array = np.flip(array, axis=1)
    else:
        array = np.flip(array, axis=0)

    array = np.ascontiguousarray(array)
    return simplejpeg.encode_jpeg(array, quality=self.q, colorspace=self.colour_space,
                                  colorsubsampling=self.colour_subsampling)

# ------------------------------------------------------------
def video_config(sensor_mode, exposure, fps, analogue_gain):
    w,h = sensor_mode['size']

    # Correct display aspect ratio
    lores_size = (640,480)
    if (h / w) <= 0.7:
        lores_size = (640,320)
    
    exposure_fps = 1 / (exposure / 1e6)
    if exposure_fps > fps:
        fdl = (1 / fps) * 1e6
    else:
        fdl = exposure
    
    fdl = round(fdl)
        
    return dict(    
        sensor={"output_size": sensor_mode['size'], "bit_depth": sensor_mode['bit_depth']},
        main={"size": sensor_mode['size'], "format": 'RGB888'},
        lores={"size": lores_size, "format": 'RGB888'},
        controls={
            'ExposureTime': exposure,
            #'FrameRate': fps,
            'FrameDurationLimits': (fdl, fdl),
            'AwbEnable': 0,
            'AeEnable': 0,
            'AnalogueGain': analogue_gain,
            'ColourGains': (1, 1),
            'Saturation': 0,
        })    


class Camera:
    def __init__(self):
        self.camera = None
            
    def get_sensor_modes(self):
        camera = picamera2.Picamera2()
        modes = camera.sensor_modes
        camera.close()
        del camera
        gc.collect()
        return modes

    def video_capture(self, path, duration, exposure, fps, analogue_gain, sensor_mode=0, preview=True):
        if not path.endswith('.mkv'):
            raise ValueError('MKV file format only currently supported.')

        camera = picamera2.Picamera2()

        benchmark = CaptureBenchmark()
        
        print('Camera arguments: ', path, duration, exposure, fps, analogue_gain, sensor_mode)
        
        print('BENCHMARK READY')

        mode = camera.sensor_modes[sensor_mode]
        print('Sensor mode retrieved')
        config = camera.create_video_configuration(**video_config(mode, exposure, fps, analogue_gain))
        print('Create video config')
        camera.configure(config)

        
        print('CONFIGURED CAMERA')
        
        mjpeg_encoder = JpegEncoder(q=80)
        mjpeg_encoder.encode_func = encode_func.__get__(mjpeg_encoder, JpegEncoder)
        mjpeg_encoder.framerate = fps
        mjpeg_encoder.size = config["main"]["size"]
        mjpeg_encoder.format = config["main"]["format"]
        mjpeg_encoder.output = FfmpegOutput(path)
        mjpeg_encoder.start()        

        print('CONFIGURED ENCODER')

        if preview:
            im_viewer = TkImageViewer()

        camera.start()
        start = timelib.time()
        benchmark.record_start()
        pg = tqdm(total=duration*fps)
        counter = 0
        while timelib.time() - start < duration:
            request = camera.capture_request()
            mjpeg_encoder.encode("main", request)

            benchmark.record_frame_time()
            benchmark.record_complete()
            
            if preview:
                if counter % (fps // 5) == 0:
                    img = request.make_array("lores")

                    if lec_version == 'V2':
                        img = np.flip(img, axis=1)
                    else:
                        img = np.flip(img, axis=0)

                    img = Image.fromarray(img) 
                    im_viewer.show_frame(img)

            request.release()
            pg.update(1)

            if counter == 0:
                start = timelib.time()

            counter += 1

        benchmark.record_end()
        mjpeg_encoder.stop()
        camera.stop()

        if preview:
            im_viewer.close()    
            del im_viewer
        
        benchmark.print_log() 

        camera.close()
        del camera
        gc.collect()

        # Export frame times
        frame_times_file = re.sub('.mkv', '_frame_times.csv', path)
        ((total, capture, ancillary), (complete, incomplete), ft) = benchmark.compute_timings()
        df = pd.DataFrame(dict(index=list(range(len(ft))), frame_time=ft))
        df.to_csv(frame_times_file)

    def still_capture(self, exposure, fps, analogue_gain, sensor_mode=0):
        camera = picamera2.Picamera2()

        mode = camera.sensor_modes[sensor_mode]
        config = camera.create_video_configuration(**video_config(mode, exposure, fps, analogue_gain))
        camera.configure(config)
       
        # Currently capture according video config, but will change to dedicated still config
        camera.start()
        start = timelib.time()
        while timelib.time() - start < 1: # Capture for 1 second
            request = camera.capture_request()
            img = request.make_array("main")
            request.release()

            if lec_version == 'V2':
                img = np.flip(img, axis=1)
            else:
                img = np.flip(img, axis=0)
    
        camera.stop()  

        camera.close()
        del camera
        gc.collect()

        return img
        
        
class LiveStream:
    def __init__(self):
        self.shutdown = False
        self.is_streaming = False
        self.benchmark = CaptureBenchmark()

    def _start(self, exposure, fps, analogue_gain, sensor_mode=0):
        self.benchmark.clear()

        camera = picamera2.Picamera2()

        mode = camera.sensor_modes[sensor_mode]
        config = camera.create_video_configuration(**video_config(mode, exposure, fps, analogue_gain))
        camera.configure(config)
        
        self.shutdown = False

        im_viewer = TkImageViewer()

        camera.start()
        self.benchmark.record_start()
        while not self.shutdown:
            request = camera.capture_request()      
            img = request.make_array("lores") 
            request.release()

            if lec_version == 'V2':
                img = np.flip(img, axis=1)
            else:
                img = np.flip(img, axis=0)

            img = Image.fromarray(img)
            im_viewer.show_frame(img)

            self.benchmark.record_frame_time()
            self.benchmark.record_complete()

        self.benchmark.record_end()
        camera.stop()
        im_viewer.close()    
        del im_viewer

        self.benchmark.print_log()

        camera.close()
        del camera
        gc.collect()

    def start(self, exposure, fps, analogue_gain, sensor_mode=0):
        thread = threading.Thread(target=self._start, args=(exposure, fps, analogue_gain, sensor_mode))
        thread.start()
        self.is_streaming = True

    def stop(self):
        self.shutdown = True
        self.is_streaming = False
        
        
def frame_to_bytes(frame):
    ret, jpeg = cv2.imencode('.jpg', frame)
    return jpeg.tobytes() 


class VideoGenerator:
    def __init__(self, exposure, fps, analogue_gain, sensor_mode=0):
        self.camera = picamera2.Picamera2()
        mode = self.camera.sensor_modes[sensor_mode]
        config = self.camera.create_video_configuration(**video_config(mode, exposure, fps, analogue_gain))
        self.camera.configure(config)
        self.benchmark = CaptureBenchmark()

    def __enter__(self):
        self.benchmark.clear()

        self.camera.start()
        self.benchmark.record_start()
        while True:
            request = self.camera.capture_request()      
            img = request.make_array("lores")
            request.release()

            self.benchmark.record_frame_time()
            self.benchmark.record_complete()

            if lec_version == 'V2':
                img = np.flip(img, axis=1)
            else:
                img = np.flip(img, axis=0)

            yield img

    def __exit__(self, exc_type, exc_value, exc_tb):
        self.benchmark.record_end()
        self.camera.stop()
        self.benchmark.print_log()
        self.camera.close()
        del self.camera
        gc.collect()



# This is for the Dash App but is not required for using the above API
class CameraSettings:
    def __init__(self):
        self.settings = {
            'framerate': 30,
            'exposure': 20000, # in u-ms, *1000 for ms
            'sensor_mode': 0,
            'analogue_gain': 1
        }

    def get(self, name):
        value = self.settings[name]
        return value

    def set(self, name, value):
        self.settings[name] = value
        
        
if __name__ == '__main__':
    import multiprocessing as mp
    import threading

    def capture():
        picam2 = Camera()
        picam2.video_capture('/home/pi/test/Pos1/timepoint1.mkv', 5, 20000, 30, 1)

    def test():
        for i in range(1000):
            process = mp.Process(target=capture)
            process.start()
            process.join()
           
    thread = threading.Thread(target=test)
    thread.start()
    thread.join()       
           
    '''
    camera = picamera2.Picamera2()    
    for i in range(500000):
        
        mode = camera.sensor_modes[0]
        config = camera.create_video_configuration(**video_config(mode, 20000, 20))
        camera.configure(config)

        camera.start()

        timelib.sleep(0.001)
        
        camera.stop()   
    
    camera.close() 
    '''
        
        
        
        #break
