EmbryoPhenomics/RoboCam/(commit log)

2026-08-10 Add initial commit.
    [multiwell_24_19.csv, multiwell_384_4.5.csv, multiwell_48_13.csv]
2026-09-18 Add electronics.
    [FUSE-HOLDER-20MM-PCB.step, Fuse_base_v1.stl, Fuse_cover_v1.stl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]
2026-10-27 Close camera after each video capture.
2026-10-27 Add calibration popup.
2026-10-27 Elevate internal flag out of threaded function.
2026-11-04 Fix exposure settings bug.
    [acquisition.py, app.py]
2026-11-06 Add pause between camera streams stop/start to prevent crashes.
    [app.py]
